cspwcspw/Yet-Another-Energy-Monitor/(threads)

Thread 1 (2021-04-26):

A0 and AREF1.1v pin in arduino uno

gowrinath3, 2021-04-26:
I an a beginner with arduino , so can you please help me with my following queries:
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

1.) In the above uno board , where are these two pins A0 and AREF1.1v ? According to your circuit (Check the above screenshots)
2.) I should upload only the CT_Clamp arduino file right ? Check the below screenshot
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
3.) How to get the voltage consumed(I clamped my current sensor on single phase 240 wire on my mainboard) and current flowing through the current sensor output on serial monitor ? If your code already consists that , please say how to get these outputs.

Please help me out as soon as possible , tbh i have my project review on coming 2 days
