cspwcspw/Yet-Another-Energy-Monitor/(commit log)

2020-01-01 Add capacitor to circuit, fix small bug
    [CT_Clamp.ino, Utils.h]
2020-01-14 Add ESP32 support, some tweaks
